username123115/jankboard/imported/connector/F31L-1A7H1-11030.step

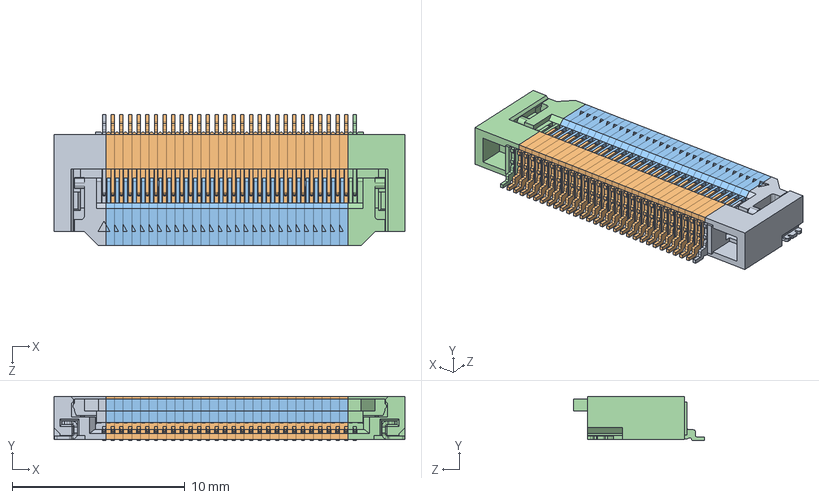
[picture p1: CAD file, 2025-03-06]
imported/connector/F31L-1A7H1-11030.step
20.3 x 2.55 x 7.57 mm
F31L_L.STEP
F31L_M.STEP x 28
F31L_R.STEP
