username123115/jankboard/imported/switch/EGJ1210AAG2R/EGJ1210AAG2.stp

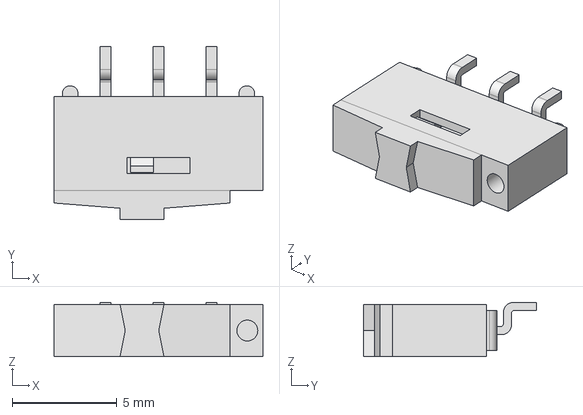
[picture p2: CAD file, 2025-03-10]
imported/switch/EGJ1210AAG2R/EGJ1210AAG2.stp
10.00 x 8.30 x 2.60 mm
