username123115/jankboard/(list of files, cad)

Other CAD files:
imported/switch/EGJ1210AAG2R/Allegro/egj1210aag2r.psm
imported/switch/EGJ1210AAG2R/DEHDL/egj1210aag2r/chips/chips.prt
