username123115/jankboard/jankboard.kicad_pcb

## KiCad design jankboard.kicad_pcb (2025-03-10)

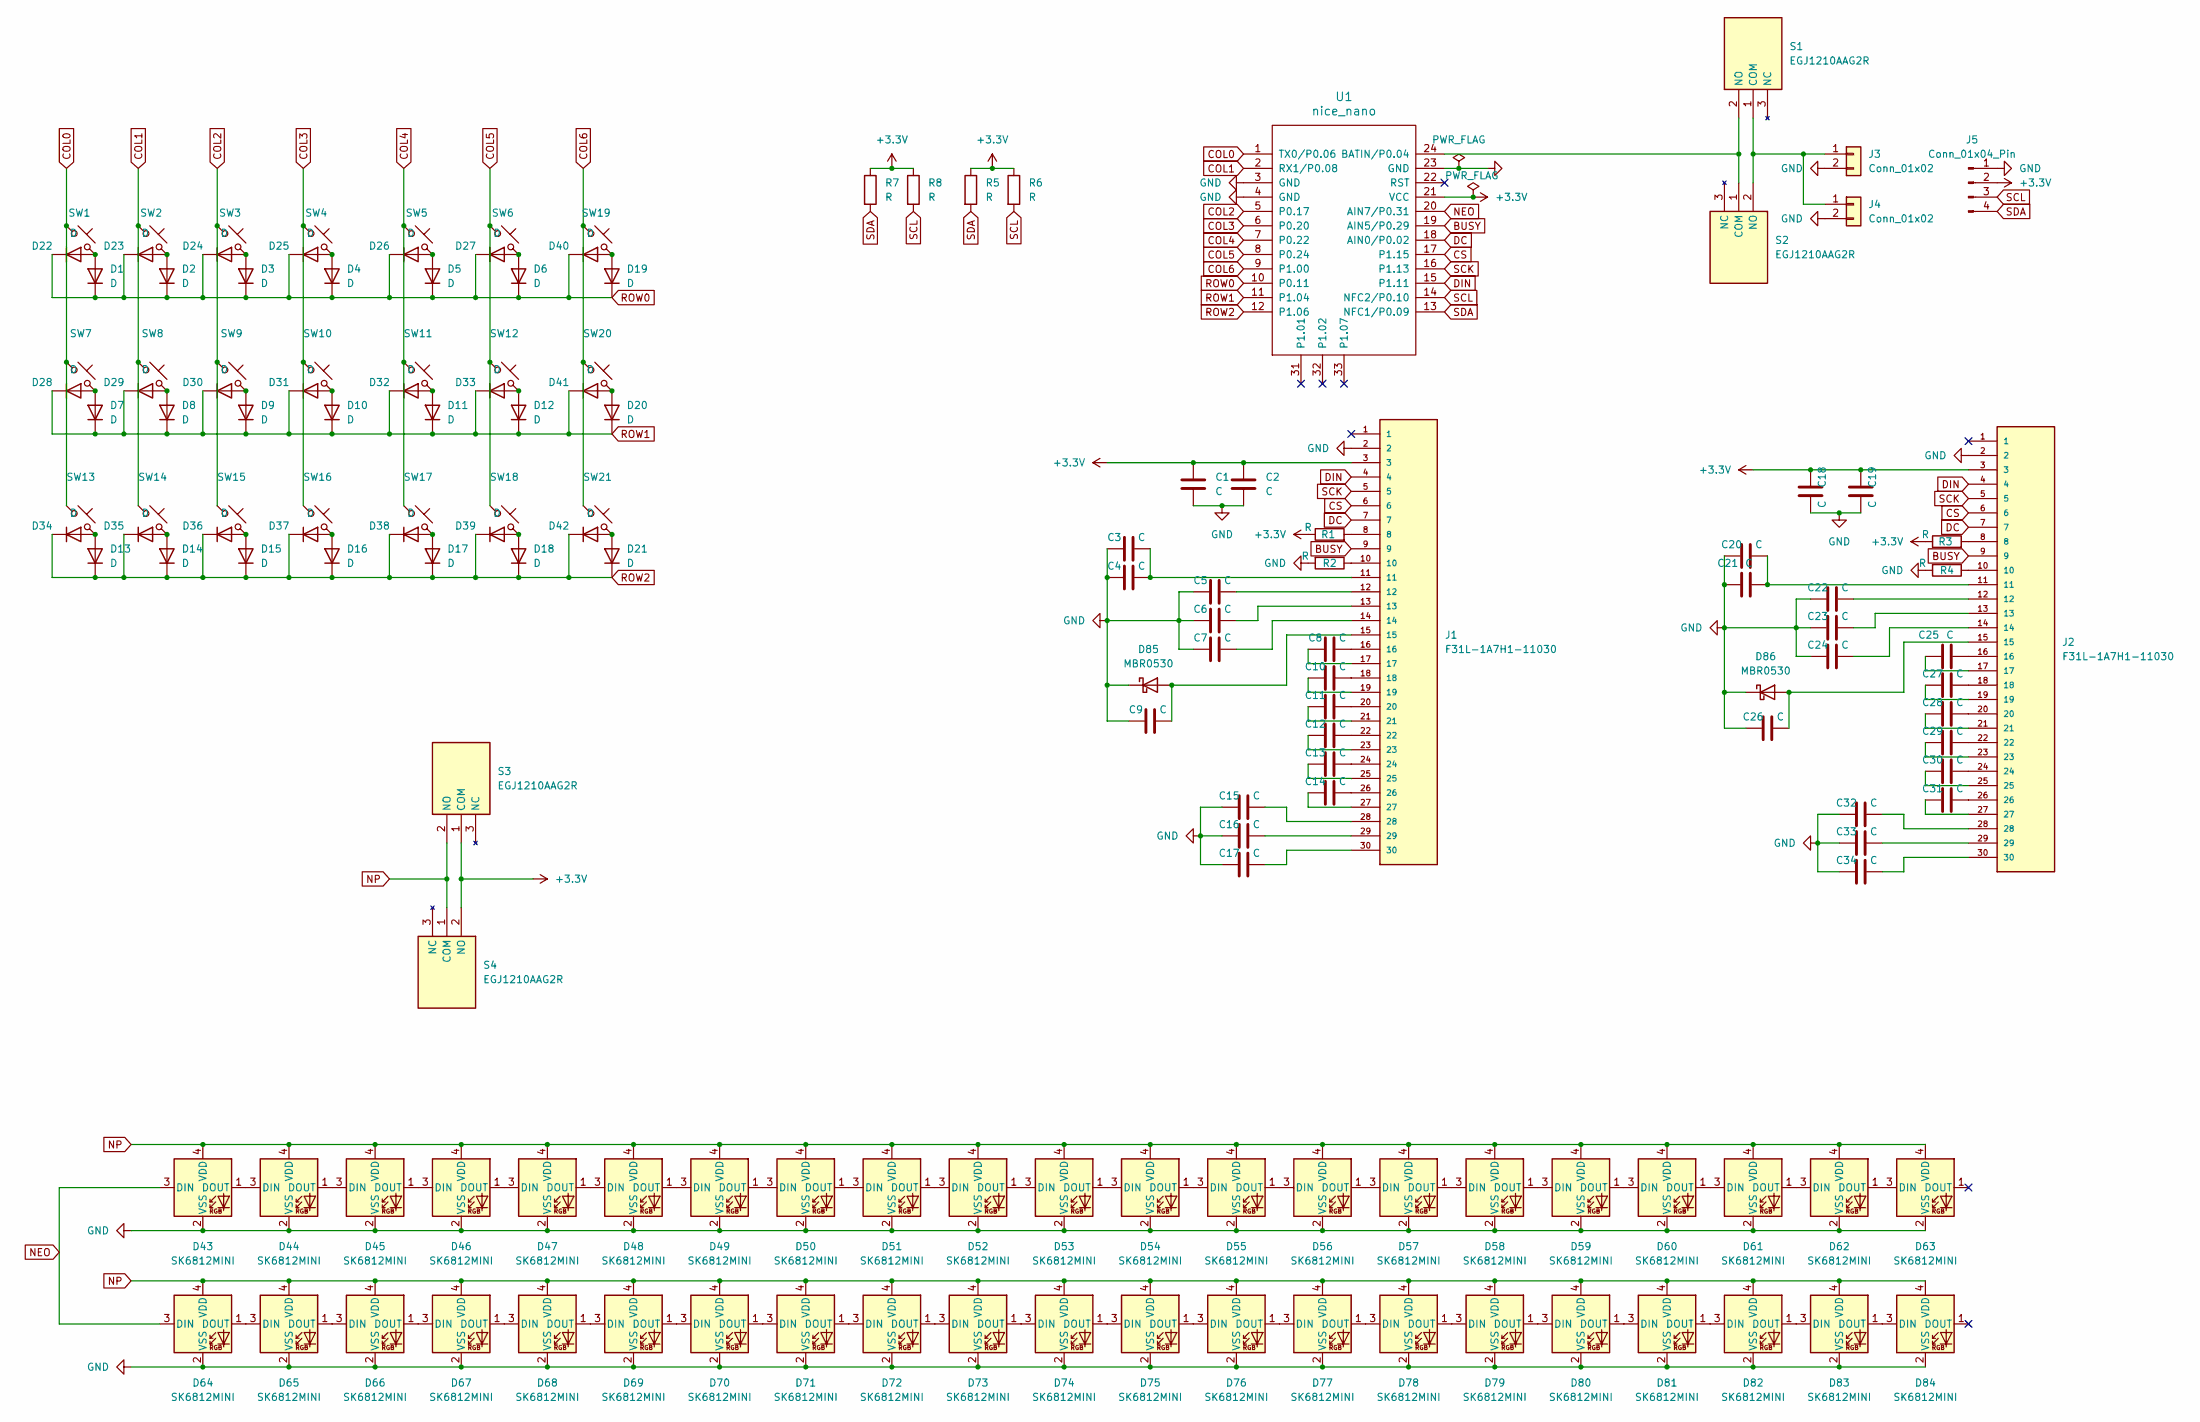
[picture p3: schematic jankboard.kicad_sch]

Parts:
C1, C2, C3, C4, C5, C6, C7, C8, C9, C10, C11, C12, C13, C14, C15, C16, C17, C18, C19, C20, C21, C22, C23, C24, C25, C26, C27, C28, C29, C30, C31, C32, C33, C34: C; C_0603_1608Metric
D1, D2, D3, D4, D5, D6, D7, D8, D9, D10, D11, D12, D13, D14, D15, D16, D17, D18, D19, D20, D21, D22, D23, D24, D25, D26, D27, D28, D29, D30, D31, D32, D33, D34, D35, D36, D37, D38, D39, D40, D41, D42: D; D_1206_3216Metric
D43, D44, D45, D46, D47, D48, D49, D50, D51, D52, D53, D54, D55, D56, D57, D58, D59, D60, D61, D62, D63, D64, D65, D66, D67, D68, D69, D70, D71, D72, D73, D74, D75, D76, D77, D78, D79, D80, D81, D82, D83, D84: SK6812MINI; LED_SK6812MINI_PLCC4_3.5x3.5mm_P1.75mm
D85, D86: MBR0530; D_SOD-123
J1, J2: F31L-1A7H1-11030; PARTREV L
J3, J4: Conn_01x02; JST_PH_S2B-PH-SM4-TB_1x02-1MP_P2.00mm_Horizontal
J5: Conn_01x04_Pin; PinHeader_1x04_P2.54mm_Vertical
R1, R2, R3, R4, R5, R6, R7, R8: R; R_0603_1608Metric
S1, S2, S3, S4: EGJ1210AAG2R; Manufacturer_Part_Number EGJ1210AAG2R
SW1, SW2, SW3, SW4, SW5, SW6, SW7, SW8, SW9, SW10, SW11, SW12, SW13, SW14, SW15, SW16, SW17, SW18, SW19, SW20, SW21: SW_Push_45deg; SW_PG1350_reversible
U1: nice_nano

Connections:
+3.3V: C1.1, C2.1, C18.1, C19.1, J1.3, J2.3, J5.2, R1.1, R3.1, R5.1, R6.1, R7.1, R8.1, S3.1 (COM), S4.2 (NO), U1.21 (VCC)
BUSY: J1.9, J2.9, U1.19 (AIN5/P0.29)
COL0: SW1.1, SW7.1, SW13.1, U1.1 (TX0/P0.06)
COL1: SW2.1, SW8.1, SW14.1, U1.2 (RX1/P0.08)
COL2: SW3.1, SW9.1, SW15.1, U1.5 (P0.17)
COL3: SW4.1, SW10.1, SW16.1, U1.6 (P0.20)
COL4: SW5.1, SW11.1, SW17.1, U1.7 (P0.22)
COL5: SW6.1, SW12.1, SW18.1, U1.8 (P0.24)
COL6: SW19.1, SW20.1, SW21.1, U1.9 (P1.00)
CS: J1.6, J2.6, U1.17 (P1.15)
DC: J1.7, J2.7, U1.18 (AIN0/P0.02)
DIN: J1.4, J2.4, U1.15 (P1.11)
GND: C1.2, C2.2, C3.1, C4.1, C5.1, C6.1, C7.1, C9.1, C15.1, C16.1, C17.1, C18.2, C19.2, C20.1, C21.1, C22.1, C23.1, C24.1, C26.1, C32.1, C33.1, C34.1, D43.2 (VSS), D44.2 (VSS), D45.2 (VSS), D46.2 (VSS), D47.2 (VSS), D48.2 (VSS), D49.2 (VSS), D50.2 (VSS), D51.2 (VSS), D52.2 (VSS), D53.2 (VSS), D54.2 (VSS), D55.2 (VSS), D56.2 (VSS), D57.2 (VSS), D58.2 (VSS), D59.2 (VSS), D60.2 (VSS), D61.2 (VSS), D62.2 (VSS), D63.2 (VSS), D64.2 (VSS), D65.2 (VSS), D66.2 (VSS), D67.2 (VSS), D68.2 (VSS), D69.2 (VSS), D70.2 (VSS), D71.2 (VSS), D72.2 (VSS), D73.2 (VSS), D74.2 (VSS), D75.2 (VSS), D76.2 (VSS), D77.2 (VSS), D78.2 (VSS), D79.2 (VSS), D80.2 (VSS), D81.2 (VSS), D82.2 (VSS), D83.2 (VSS), D84.2 (VSS), D85.1 (K), D86.1 (K), J1.2, J2.2, J3.2, J4.2, J5.1, R2.2, R4.2, U1.3 (GND), U1.4 (GND), U1.23 (GND)
NEO: D43.3 (DIN), D64.3 (DIN), U1.20 (AIN7/P0.31)
NP: D43.4 (VDD), D44.4 (VDD), D45.4 (VDD), D46.4 (VDD), D47.4 (VDD), D48.4 (VDD), D49.4 (VDD), D50.4 (VDD), D51.4 (VDD), D52.4 (VDD), D53.4 (VDD), D54.4 (VDD), D55.4 (VDD), D56.4 (VDD), D57.4 (VDD), D58.4 (VDD), D59.4 (VDD), D60.4 (VDD), D61.4 (VDD), D62.4 (VDD), D63.4 (VDD), D64.4 (VDD), D65.4 (VDD), D66.4 (VDD), D67.4 (VDD), D68.4 (VDD), D69.4 (VDD), D70.4 (VDD), D71.4 (VDD), D72.4 (VDD), D73.4 (VDD), D74.4 (VDD), D75.4 (VDD), D76.4 (VDD), D77.4 (VDD), D78.4 (VDD), D79.4 (VDD), D80.4 (VDD), D81.4 (VDD), D82.4 (VDD), D83.4 (VDD), D84.4 (VDD), S3.2 (NO), S4.1 (COM)
unnamed: C3.2, C4.2, J1.11
unnamed: C5.2, J1.12
unnamed: C6.2, J1.13
unnamed: C7.2, J1.14
unnamed: C8.1, J1.17
unnamed: C8.2, J1.16
unnamed: C10.1, J1.19
unnamed: C10.2, J1.18
unnamed: C11.1, J1.21
unnamed: C11.2, J1.20
unnamed: C12.1, J1.23
unnamed: C12.2, J1.22
unnamed: C13.1, J1.25
unnamed: C13.2, J1.24
unnamed: C14.1, J1.27
unnamed: C14.2, J1.26
unnamed: C15.2, J1.28
unnamed: C16.2, J1.29
unnamed: C17.2, J1.30
unnamed: C20.2, C21.2, J2.11
unnamed: C22.2, J2.12
unnamed: C23.2, J2.13
unnamed: C24.2, J2.14
unnamed: C25.1, J2.17
unnamed: C25.2, J2.16
unnamed: C27.1, J2.19
unnamed: C27.2, J2.18
unnamed: C28.1, J2.21
unnamed: C28.2, J2.20
unnamed: C29.1, J2.23
unnamed: C29.2, J2.22
unnamed: C30.1, J2.25
unnamed: C30.2, J2.24
unnamed: C31.1, J2.27
unnamed: C31.2, J2.26
unnamed: C32.2, J2.28
unnamed: C33.2, J2.29
unnamed: C34.2, J2.30
unnamed: D1.2 (A), D22.2 (A), SW1.2
unnamed: D2.2 (A), D23.2 (A), SW2.2
unnamed: D10.2 (A), D31.2 (A), SW10.2
unnamed: D11.2 (A), D32.2 (A), SW11.2
unnamed: D12.2 (A), D33.2 (A), SW12.2
unnamed: D13.2 (A), D34.2 (A), SW13.2
unnamed: D14.2 (A), D35.2 (A), SW14.2
unnamed: D15.2 (A), D36.2 (A), SW15.2
unnamed: D16.2 (A), D37.2 (A), SW16.2
unnamed: D17.2 (A), D38.2 (A), SW17.2
unnamed: D18.2 (A), D39.2 (A), SW18.2
unnamed: D19.2 (A), D40.2 (A), SW19.2
unnamed: D20.2 (A), D41.2 (A), SW20.2
unnamed: D21.2 (A), D42.2 (A), SW21.2
unnamed: D3.2 (A), D24.2 (A), SW3.2
unnamed: D4.2 (A), D25.2 (A), SW4.2
unnamed: D5.2 (A), D26.2 (A), SW5.2
unnamed: D6.2 (A), D27.2 (A), SW6.2
unnamed: D7.2 (A), D28.2 (A), SW7.2
unnamed: D8.2 (A), D29.2 (A), SW8.2
unnamed: D9.2 (A), D30.2 (A), SW9.2
unnamed: D43.1 (DOUT), D44.3 (DIN)
unnamed: D44.1 (DOUT), D45.3 (DIN)
unnamed: D45.1 (DOUT), D46.3 (DIN)
unnamed: D46.1 (DOUT), D47.3 (DIN)
unnamed: D47.1 (DOUT), D48.3 (DIN)
unnamed: D48.1 (DOUT), D49.3 (DIN)
unnamed: D49.1 (DOUT), D50.3 (DIN)
unnamed: D50.1 (DOUT), D51.3 (DIN)
unnamed: D51.1 (DOUT), D52.3 (DIN)
unnamed: D52.1 (DOUT), D53.3 (DIN)
unnamed: D53.1 (DOUT), D54.3 (DIN)
unnamed: D54.1 (DOUT), D55.3 (DIN)
unnamed: D55.1 (DOUT), D56.3 (DIN)
unnamed: D56.1 (DOUT), D57.3 (DIN)
unnamed: D57.1 (DOUT), D58.3 (DIN)
unnamed: D58.1 (DOUT), D59.3 (DIN)
unnamed: D59.1 (DOUT), D60.3 (DIN)
unnamed: D60.1 (DOUT), D61.3 (DIN)
unnamed: D61.1 (DOUT), D62.3 (DIN)
unnamed: D62.1 (DOUT), D63.3 (DIN)
unnamed: D64.1 (DOUT), D65.3 (DIN)
unnamed: D65.1 (DOUT), D66.3 (DIN)
unnamed: D66.1 (DOUT), D67.3 (DIN)
unnamed: D67.1 (DOUT), D68.3 (DIN)
unnamed: D68.1 (DOUT), D69.3 (DIN)
unnamed: D69.1 (DOUT), D70.3 (DIN)
unnamed: D70.1 (DOUT), D71.3 (DIN)
unnamed: D71.1 (DOUT), D72.3 (DIN)
unnamed: D72.1 (DOUT), D73.3 (DIN)
unnamed: D73.1 (DOUT), D74.3 (DIN)
unnamed: D74.1 (DOUT), D75.3 (DIN)
unnamed: D75.1 (DOUT), D76.3 (DIN)
unnamed: D76.1 (DOUT), D77.3 (DIN)
unnamed: D77.1 (DOUT), D78.3 (DIN)
unnamed: D78.1 (DOUT), D79.3 (DIN)
unnamed: D79.1 (DOUT), D80.3 (DIN)
unnamed: D80.1 (DOUT), D81.3 (DIN)
unnamed: D81.1 (DOUT), D82.3 (DIN)
unnamed: D82.1 (DOUT), D83.3 (DIN)
unnamed: D83.1 (DOUT), D84.3 (DIN)
unnamed: C9.2, D85.2 (A), J1.15
unnamed: C26.2, D86.2 (A), J2.15
unnamed: J1.8, R1.2
unnamed: J1.10, R2.1
unnamed: J2.8, R3.2
unnamed: J2.10, R4.1
unnamed: J3.1, J4.1, S1.1 (COM), S2.2 (NO)
unnamed: S1.2 (NO), S2.1 (COM), U1.24 (BATIN/P0.04)
ROW0: D1.1 (K), D2.1 (K), D3.1 (K), D4.1 (K), D5.1 (K), D6.1 (K), D19.1 (K), D22.1 (K), D23.1 (K), D24.1 (K), D25.1 (K), D26.1 (K), D27.1 (K), D40.1 (K), U1.10 (P0.11)
ROW1: D7.1 (K), D8.1 (K), D9.1 (K), D10.1 (K), D11.1 (K), D12.1 (K), D20.1 (K), D28.1 (K), D29.1 (K), D30.1 (K), D31.1 (K), D32.1 (K), D33.1 (K), D41.1 (K), U1.11 (P1.04)
ROW2: D13.1 (K), D14.1 (K), D15.1 (K), D16.1 (K), D17.1 (K), D18.1 (K), D21.1 (K), D34.1 (K), D35.1 (K), D36.1 (K), D37.1 (K), D38.1 (K), D39.1 (K), D42.1 (K), U1.12 (P1.06)
SCK: J1.5, J2.5, U1.16 (P1.13)
SCL: J5.3, R6.2, R8.2, U1.14 (NFC2/P0.10)
SDA: J5.4, R5.2, R7.2, U1.13 (NFC1/P0.09)

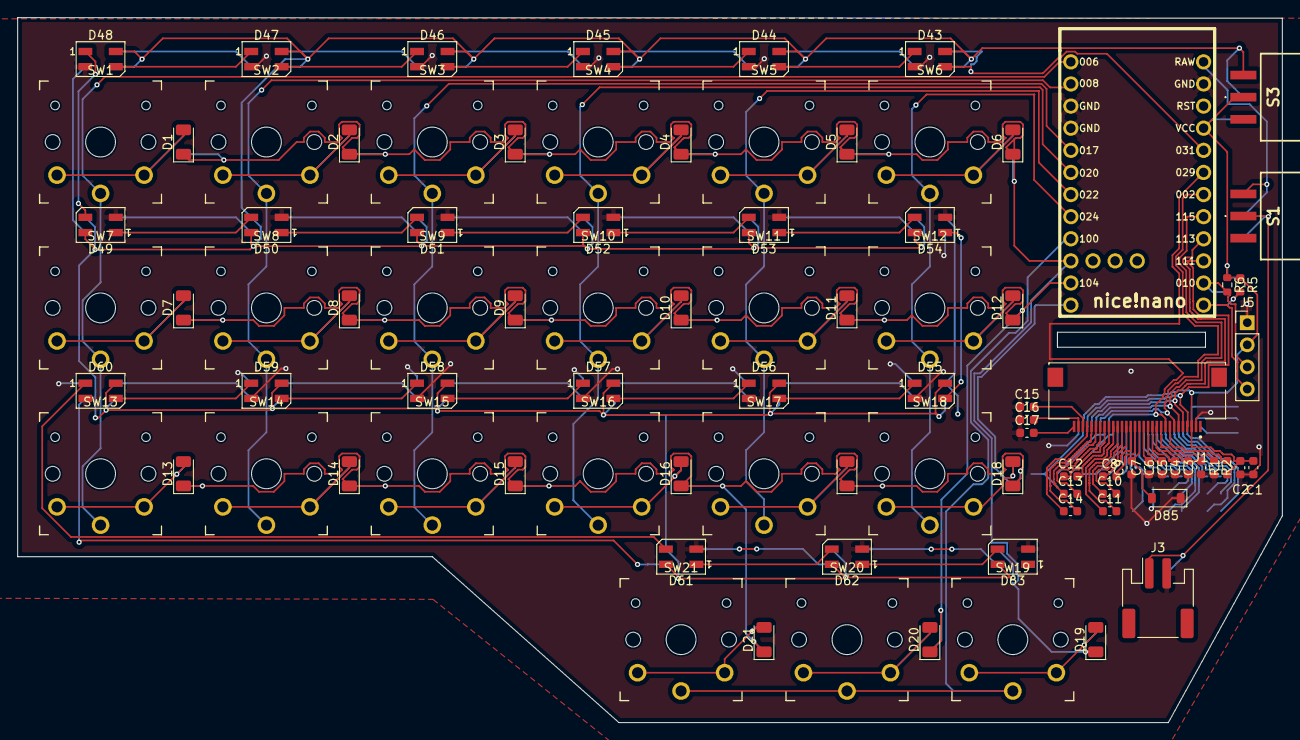
[picture p4: board jankboard.kicad_pcb from above]

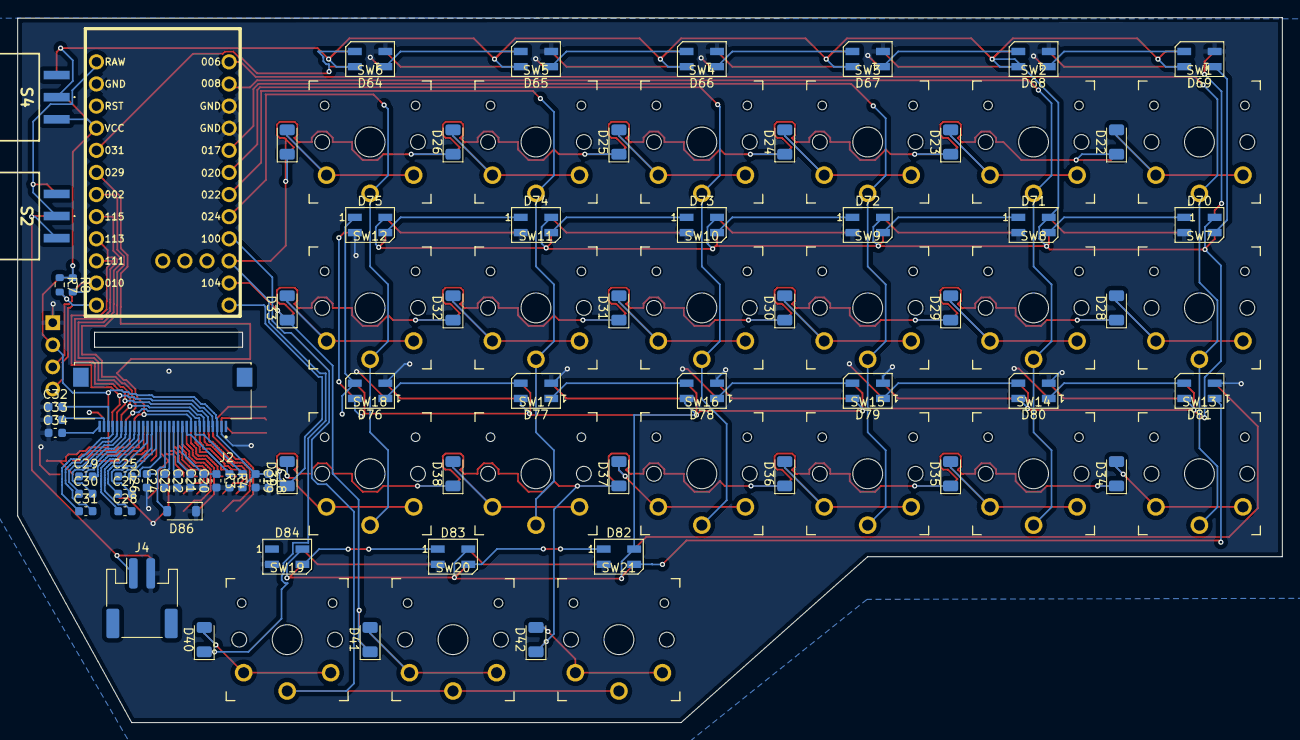
[picture p5: board jankboard.kicad_pcb from below]

Board: 2 copper layers, 145.3 x 81.0 mm, 159 parts (68 on the bottom side), 128 nets.
