username123115/jankboard/(commit log)

2025-03-02 add symbols again
    [jankboard.kicad_sch]
2025-03-06 gross shcematiasdf
    [F31L-1A7H1-11030.step, jankboard.kicad_sch]
2025-03-06 add low profile switch library
    [jankboard.kicad_sch]
2025-03-06 place keys and leds
    [jankboard.kicad_pcb, jankboard.kicad_sch]
2025-03-06 wired up matrix
    [jankboard.kicad_pcb]
2025-03-07 design rule checking
    [EDI2CAP.CFG, chips.prt, egj1210aag2r.psm, jankboard.kicad_pcb, jankboard.kicad_sch]
2025-03-10 remove via on pins, change pin footprint
    [jankboard.kicad_pcb, jankboard.kicad_sch]
2025-03-10 add led switch
    [jankboard.kicad_pcb, jankboard.kicad_sch]
2025-03-10 add models
    [EGJ1210AAG2.stp, jankboard.kicad_pcb]
2025-03-10 make room for hole
    [jankboard.kicad_pcb]
2025-03-10 add hole
    [jankboard.kicad_pcb]
2025-03-10 elongate holes slightly for better clearance of fpc cable
    [jankboard.kicad_pcb]
